Anastien/ACDC120V24/README.md

A generic 120 W, 24 V ac/dc power supply.
