Anastien/ACDC120V24/02_DOCS/DESIGN/Copy of slvc104j.xls

Sheet: Introduction
Designing with the UCC28600 Quasi-Resonant Flyback Converter
 | This worksheet is designed for use with Microsoft Excel 5.0 or later. Its use is intended to assist power supply designers in their |  | © 2013
 | routine, day-to-day calculations.
 |  |  | slvs104J
 | Component values are calculated as ideal, not to nearest production values
 |  | Disclaimer
 |  | This product is designed as an aid for customers of Texas Instruments. No warranties, either express
 |  | or implied, with respect to this software or its fitness for any particular purpose is claimed by Texas
 |  | Instruments or the author. The software is licensed solely on an "as is" basis. The entire risk as to its
 |  | quality and performance is with the customer.

Sheet: Instructions
QR Design Tool Instructions
Be sure to Enable the Macros and to have a check in the AnalysisT oolPak box in the Add-Ins section of the Tools menu.
Quasi-Resonant (QR) flyback converter design is an iterative process. This design tool reduces the hardware iterations by simulating the steady state operating maps that show the converter modes under different input and load conditions. Design adjustments can be explored in order to optimize the power system. Although the design spreadsheet is organized around a bridge rectifier – bulk capacitor line rectifier, it can be used for fixed output Power Factor Corrector (PFC) or voltage follower PFC systems. Systems with PFC must allow the QR flyback stage to start-up under the low ac line condition. However, the steady state conduction losses to the QR flyback stage will only occur at the PFC bulk capacitor voltage levels.
To use this tool, enter the voltages, power levels and converter estimates into the appropriate spaces of the QR Design Tool worksheet. This step also requires an initial selection of the power MOSFET and the output rectifier. Enter data in the cells with the BLUE text; the calculated values are in the cells with the RED text. The parameters for the UCC28600 are already included. The design tool will generate a recommended design that includes transformer parameters. Verify that the current and voltage stresses are compatible with the MOSFET and output rectifier that were initially selected. The recommended values in the design may not be practical due to integer transformer turns, standard values, etc. Yet the operation of the converter can be significantly altered by using the closest parameter.
At this point, design the transformer using the magnetizing inductance and approximate turns ratio that was recommended by the QR Design Tool worksheet. The Magnetic Specification sheet can be printed and used as a guideline for the recommended transformer design. The next step is to see how the design performs using the QR Simulator worksheet.
The QR Simulator will carry over the Converter Requirements, MOSFET Specifications, Diode Data and the UCC28600 Characteristics. The transformer information and the programming components, RS (current sense resistance), RPL (power limit programming), ROVP1 and ROVP2 (over-voltage programming resistors) must be entered by the user. The recommended values are shown beside the cells as a reminder for the ideal values.
After entering the final values, examine the operating maps. They reveal the boundaries of the different modes of operation. The operating maps portray the power levels, peak switch currents, feed back voltages and switching frequencies for the full array of line voltages and loads that the converter would experience. These maps can be used to explore design alternatives, such as different current sense resistor values, different transformers, etc. For example, it might be desirable to change the power level where burst mode occurs in order to avoid audio noise at a common load operating point. The QR Simulator worksheet also shows rms currents, whether the converter is in power limit, the operational mode among other potentially useful data that can be used to optimize the converter performance in a specific power system.
For PFC systems that have a fixed bulk voltage, estimate the PFC output voltage at the peak of its ripple. Calculate the equivalent ac voltage to achieve that maximum voltage level. Enter that ac voltage as the VAC(max) level. Enter the minimum operational ac line voltage as the VAC(min) level because the QR Flyback must power up correctly in order to start the PFC stage.
For voltage follower PFC systems, estimate the PFC output voltage at the peak of its ripple during maximum line conditions. Calculate the equivalent ac voltage to achieve that maximum voltage level. Enter that ac voltage as the VAC(max) level. Enter the minimum ac line voltage as the VAC(min) level because the QR Flyback must power up correctly in order to start the PFC stage. In the least, converter must be designed to operate at safe temperatures under the steady state operating rms currents that occur at the minimum PFC voltage and at the maximum PFC voltage. The data tables in the QR Simulator worksheet can assist in finding the required values.

Sheet: QR Design Tool
UCC28600 Design Spreadsheet
TI Literature Number - SLVC104J - April 2017
Design Synthesis - type in the blue data and the spreadsheet responds with the calculated red data. Bold RED results are recommended COMPONENT VALUES.
 |  |  |  |  |  |  | Comments on REQUIRED USER INPUTS:
 |  |  |  |  |  |  | ALL CELLS WITH BLUE TEXT MUST BE VERIFIED AND UPDATED BY THE USER FOR EACH DESIGN.
Converter Requirements
POUT(max) limit | 150 | W |  |  |  |  | - POUT(max) limit is maximum output power of converter (enter, in W, into cell C10)
RLOAD = | 3.840 | W, VOUT2/POUT |  |  |  |  | - POUT during SS, default: use POUT(max) if design will start into full load (enter, in W, into cell C11)
efficiency ratio | 0.8 |  |  |  |  |  | - efficiency ratio is the Expected converter efficiency (enter, in decimal form, in cell C12)
PIN = | 187.500 | W |  |  |  |  | - Resultant input power from User input (calculated by spreadsheet)
VAC(min) | 85 | VAC | VBULK(min_pk) = | 120.208 | V, VAC(min)Ö2 |  | - VAC(min) is the minimum AC line input voltage (enter, in VAC, in cell C14)
VAC(max) ** | 264 | VAC | VBULK(min_valley) = | 90.156 | V, minus ripple |  | - **For systems with a PFC front end, the VAC(max) value entered into cell C15 should be equivalent to the maximum regulated output voltage of the PFC stage divided by SQRT(2), as calculated by the USER, otherwise, for systems that DO NOT have a PFC input stage, enter the maximum AC line input voltage. (enter, in VAC, in cell C15)
VBULK(ripple), %pp | 25 | % | VBULK(max_pk) = | 373.352 | V, VAC(max)Ö2 |  | - VBULK(ripple), %pp is the ripple voltage on the input voltage (enter the percentage of peak to peak ripple voltage on the input bus in cell C16)
VAC(max) shutdown margin % | 10 | % | VBULK(ov) = | 410.688 | V, plus ripple |  | - VAC(max) shutdown margin % is the User programmable Line Over Voltage Protection limit (enter the percentage of margin that the line voltage can exceed VAC(max) before initiating Line OVP, in cell C17)
Required INPUT CAPACITOR | 470 | uF |  |  |  |  | INPUT CAPACITOR: required minimum input capacitor to meet required VBULK(min_valley) for power stage
Actual Input Capacitor Used | 390 | uF |  |  |  |  | Actual INPUT CAPACITOR used for design. Actual value required for power stage calculations
Actual minimum bulk voltage | 82.847 | V |  |  |  |  | Actual minimum bulk voltage resultant from selection of input capacitor value
fS(min) | 80000 | Hz, low line, max load | tS(min) = | 1.25e-05 | s |  | - Minimum switching frequency at maximum load, minimum input should not be less than 80kHz. Locking this value to 80kHz ensures proper timing for the internal logic of the controller and is not user programable
VOUT | 24 | VDC |  |  |  |  | - VOUT is the regulated output voltage of the converter (enter, in Volts, in cell C19)
VOUT(ripple), max pp | 0.05 | V |  |  |  |  | - VOUT(ripple), max pp is the maximum peak to peak output ripple of the converter output, i.e. usually equal to 1% of the regulated output voltage (enter, in Volts, in cell C20)
VOUT(shutdown) | 17.5 | V |  |  |  |  | - VOUT(shutdown) is the User programmable Output Over Voltage Protection limit (enter, in Volts, the maximum output voltage that will initiate Load OVP in cell C21)
Load step, Watts | 65 | W |  |  |  |  | - Load step is the maximum output load transient, in Watts, i.e. no-load to full load (enter, in Watts, in cell C22)
max dVOUT due to Load step | 0.2 | V |  |  |  |  | - max dVOUT due to Load step is the maximum output voltage deviation due to a transient or load step (enter, in Volts, in cell C23)
estimated fCO, Hz | 3000 | Hz |  |  |  |  | - estimated fCO is the desired crossover frequency of the control loop, usually between 2kHz and 3kHz (enter, in Hertz such as 3.0E+3, in cell C24)
VBIAS at full load | 12 | V |  |  |  |  | - VBIAS is the output of the Aux winding of the Flyback Transformer, used to BIAS the UCC28600 and, if used, also the PFC controller. VBIAS must be equal to the maximum UVLO stop threshold of the UCC28600 (equal to 9.3V) or the maximum start up voltage of the PFC controller, whichever is greater. (enter, in Volts, in cell C25)
Snubber overshoot % of reflected VOUT | 50 | % |  |  |  |  | - Snubber overshoot % of reflected VOUT is used to determine the snubber components. The percentage value entered in this cell will be used to determine the clamp voltage, taking into account the derated VDS of the switch, the maximum input voltage, and the reflected output voltage. Recommended 50% as default value. (enter, as a percentage, in cell C26)
MOSFET Specifications |  |  |  |  |  |  | The User selects a MOSFET for the design and inputs the FET's characteristics:
VDS(max) rating | 800 | V |  |  |  |  | - VDS(max) rating is the chosen FET's drain to Source maximum voltage rating (enter, as Volts, in cell C30)
VDS derate % | 15 | % |  |  |  |  | - VDS derate % is the User chosen derating (for safety margin) of the VDS voltage on the FET (enter, as a percentage, in cell C31)
VDS(max) limit = | 680 | V |  |  |  |  | - Resultant maximum allowed voltage on switch due to User selected derating
COSS estimate, at VDS test V | 3.9e-10 | F | VDS test V | 25 | V |  | - COSS is the output capacitance of the chosen MOSFET as stated in the MOSFET data sheet (enter, in Farads, in cell C33). VDS test V is the defined voltage, found in the MOSFET data sheet, that the COSS specification is tested at (enter, in Volts, in cell F33).
Co', F-sqrt(V) = | 1.95e-09 | F
CDS, stray | 5e-11 | F |  |  |  |  | - CDS, stray is the estimated parasitic Drain to Source capacitance (enter, in Farads, in cell C35) ex.TO-220 tab to GND is about 25 pF
CISS | 1.2e-09 | F |  |  |  |  | - CISS is the input capacitance of the chosen MOSFET as stated in the MOSFET data sheet (enter, in Farads, in cell C36).
Qg | 6e-08 | C |  |  |  |  | - Qg is the total gate charge of the chosen MOSFET as stated in the MOSFET data sheet (enter, in Cou;ombs, in cell C37).
Transformer Estimates
Leakage to magnetizing inductance % | 2.5 | %mag Ind | Leakage to magnetizing inductance ratio = | 0.025 |  |  | - Leakage to magnetizing inductance % is the desired magnetizing inductance of the Flyback transformer (enter, as a percent, in cell C39)
Diode Estimates
VF | 0.700 | V |  |  |  |  | - VF is the forward voltage drop of the User-selected output rectifier as found in the rectifier data sheet (enter, as a voltage, in cell C43)
UCC28600 Parameters |  |  |  |  | Internal IC parameters |  | - The parameters within the blue box are internal to the UCC28600 and are not User programmable.
VFB, no load | 4.87 | V, = VREF in chip, @ no load
RFB | 20000 | W, internal to chip
VFB at Burst/FFM boundary | 1.4 | V
ACS(FB) | 2.5 | Gain, VFB/VCS
VCS(OS), CS offset volts | 0.4 | V, typ value from data sheet
VPL, power limit | 1.2 | V, typical CS value during power limit
VPL - VCS(OS) | 0.8 | V, CS working range
VFB @ power limit | 3 | V, VPL X ACS(FB)
VFB at FFM boundary | 2 | V
fQR(max) clamp | 130000 | Hz
fQR(min) clamp | 40000 | Hz
IOVP(line) | 0.00045 | A, Line OVP typical value in data sheet
VOVP(on), ON state | -0.025 | V, typ VOVP OUT = HIGH
VOVP(load) | 3.75 | V, Load OVP typical value in data sheet
IPL(CS)/IOVPon), current gain during OUT = ON state | 0.5 | 150 mA/300 mA
VCS at DCM/FFM | 0.4 | V, (VFB/ACS(FB)) - VCS(OS)
IP/IP(max) at DCM/FFB boundary | 0.5
VCO gain, TS/VFB | -2.884615385e-05
VCO offset, TS(VFB = 0) | 6.538461538e-05 | V
ISS(chg) | 6e-06 | A, SS charge current
Resulting Converter Features |  |  |  |  |  |  | Note: RS and RPL and the snubber follow simulation because the results are used in their calculation.
VXFMR, reflect | 204.432 | V |  |  |  |  | - calculated allowable reflected output voltage
VDS1(OS) | 102.216 | V |  |  |  |  | - calculated Drain-Source overshoot voltage
ZVS at VAC(min_valley)? | TRUE |  |  |  |  |  | - TRUE only if VXFMR,reflect > VBULK(min_valley), FALSE = valley switching
ZVS at VAC(max_pk)? | FALSE |  |  |  |  |  | - TRUE only if VXFMR,reflect > VBULK(max_pk), FALSE = valley switching
COSS @ VAC(min) | 8.083661252e-11 | F |  |  |  |  | - calaculated circuit capacitances
CDS(total) @ VAC(min) | 1.308366125e-10 | F
COSS @ VAC(max) | 5.265419299e-11 | F
CDS(total) @ VAC(max) | 1.02654193e-10 | F
RLOAD, reflect to pri | 222.892 | W |  |  |  |  | - calculated maximum load impedance based upon the reflected output voltage
tON / sqrt(L) | 0.0008264056844 | s |  |  |  |  | - calculated timing segments normalized with respect to the primary inductance
tLEAKAGE / sqrt(L) | 2.032719204e-06 | s
tOFF / sqrt(L) | 0.0003349055169 | s
tVALLEY / sqrt(L) | 3.183011585e-05 | s
min NPRI / NSEC | 8.277 | turns, N = VXFMR/(VOUT+VF) |  |  |  |  | - min NPRI / NSEC is the Minimum Turns Ratio for the Primary to Secondary Windings (this value is carried over to the Simulator page)
min NPRI / NBIAS | 16.553 | turns, NBIAS = N*(VOUT/VBIAS) |  |  |  |  | - min NPRI / NBIAS is the Minimum Turns Ratio for the Primary to Bias (AUX) Windings (this value is inverted and carried over to the Simulator page)
max Lpri at VAC(min) | 9.844648973e-05 | H |  |  |  |  | - max L at VAC(max) is the Calculated Primary Inductance (this value is carried over to the Simulator page)
LLEAKAGE(max) | 2.461162243e-06 | H |  |  |  |  | - LLEAKAGE(max) is the Allowable Leakage Inductance (this value is carried over to the Simulator page)
Total L input | 0.000100907652 | H | Lpri+Lleakage
1+ROVP1/ROVP2 | 2.427
ROVP1 | 54998.95835 | W |  |  |  |  | - ROVP1 is the ideal value of the top resistor on the OVP pin (this value is adjusted for actual turns ratio and carried over to the Simulator page)
ROVP2 | 38550.67174 | W |  |  |  |  | - ROVP2 is the ideal value of the bottom resistor on the OVP pin (this value is adjusted for actual turns ratio and carried over to the Simulator page)
Ideal Design Using MIN NPRI / NSEC and MAX L over VAC Range @ MAX Load
Trial: the step number for the coresponding input voltage test condition | VBULK: the voltage across the bulk capacitor, iterations begin at the minimum valley voltage | VAC(equiv): the corresponding AC input voltage that would result in VBULK | ZVS ?: if TRUE, converter is zero voltage switching, if FALSE, converter is Valley switching | CDS, total: total drain to source capacitance | IPEAK: calculated peak primary current at maximum load taking into account operating mode | TON: calculated on time at maximum load | TS: calculated switching period at maximum load | IPRI(rms): primary side rms current | TDEMAG: time required for the inductor to demagnetize at maximum load | ISEC(rms): secondary side rms current at maximum load | D: duty cycle
Trial | VBULK | VAC(equiv) | ZVS ? | CDS, total | IPEAK | TON | TS | IPRI(rms) | TDEMAG | ISEC(rms) | D | VOUT/D | resonant leakage | resonant | TR, dMAG(valley) | residue dMAG(l) | Vv, valley VDS
 | V | V |  | F | A | s | s | A, rms | s | A, rms |  | V | time TL1=Tr / (2pi) | f, reset, Hz | seconds | Amps | Volts | TZV | IP1 | TS1 | TL2 | TE1 | IP2 | a | b | c | d
0 | 82.847 | 58.582 | TRUE | 2.800979652e-10 | #NAME? | #NAME? | #NAME? | #NAME? | #NAME? | #NAME? | #NAME? | #NAME? | 2.625579053e-08 | 946679.787 | 3.342299459e-07 | -0.3152434303 | 0 | 3.746010026e-07 | 6.360763413 | 1.088707758e-05 | 1.265040324e-08 | 1.163481472e-05 | 6.967568738 | 2.625239726e-07 | -1.66985288e-06 | -7.35086739e-07 | -8.046622211e-08
1 | 97.372 | 68.853 | TRUE | 2.744925988e-10 | #NAME? | #NAME? | #NAME? | #NAME? | #NAME? | #NAME? | #NAME? | #NAME? | 2.599174523e-08 | 956296.9306 | 3.440485155e-07 | -0.3001512357 | 0 | 3.034622194e-07 | 5.685548217 | 8.698362984e-06 | 1.457080181e-08 | 9.386436265e-06 | 6.288678913 | 2.625239726e-07 | -1.492592704e-06 | -6.735024801e-07 | -8.284299626e-08
2 | 111.898 | 79.124 | TRUE | 2.692778891e-10 | #NAME? | #NAME? | #NAME? | #NAME? | #NAME? | #NAME? | #NAME? | #NAME? | 2.574367056e-08 | 965512.1297 | 3.544061675e-07 | -0.2829573156 | 0 | 2.489431949e-07 | 5.185630361 | 7.235956473e-06 | 1.642625907e-08 | 7.881475765e-06 | 5.789446174 | 2.625239726e-07 | -1.361352283e-06 | -6.29093033e-07 | -8.518050777e-08
3 | 126.423 | 89.394 | TRUE | 2.644104704e-10 | #NAME? | #NAME? | #NAME? | #NAME? | #NAME? | #NAME? | #NAME? | #NAME? | 2.550994054e-08 | 974358.4523 | 3.654832511e-07 | -0.2632872077 | 0 | 2.050237884e-07 | 4.800587877 | 6.201284855e-06 | 1.822306648e-08 | 6.815524902e-06 | 5.407990466 | 2.625239726e-07 | -1.2602694e-06 | -5.960169801e-07 | -8.748143202e-08
4 | 140.948 | 99.665 | TRUE | 2.598534302e-10 | #NAME? | #NAME? | #NAME? | #NAME? | #NAME? | #NAME? | #NAME? | #NAME? | 2.528915679e-08 | 982864.9642 | 3.775460135e-07 | -0.2405710514 | 0 | 1.680289784e-07 | 4.494905685 | 5.436682861e-06 | 1.996663779e-08 | 6.027513648e-06 | 5.107973686 | 2.625239726e-07 | -1.180020497e-06 | -5.708641487e-07 | -8.974815372e-08
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
17 | 329.777 | 233.187 | FALSE | 1.636737962e-10 | #NAME? | #NAME? | #NAME? | #NAME? | #NAME? | #NAME? | #NAME? | #NAME? | 2.007056969e-08 | 1238421.558 | 4.037397417e-07 | 0 | 125.344843 | 0 | 2.97148654 | 2.3759668e-06 | 2.942497134e-08 | 2.829202083e-06 | 3.626780183 | 2.625239726e-07 | -7.800864512e-07 | -4.238103114e-07 | -8.743590629e-08
18 | 344.302 | 243.458 | FALSE | 1.606328595e-10 | #NAME? | #NAME? | #NAME? | #NAME? | #NAME? | #NAME? | #NAME? | #NAME? | 1.988324744e-08 | 1250088.863 | 3.999715659e-07 | 0 | 139.8701067 | 0 | 2.923513625 | 2.299868883e-06 | 3.015024333e-08 | 2.74987394e-06 | 3.58293307 | 2.625239726e-07 | -7.674924109e-07 | -4.198548133e-07 | -8.814464717e-08
19 | 358.827 | 253.729 | FALSE | 1.578579534e-10 | #NAME? | #NAME? | #NAME? | #NAME? | #NAME? | #NAME? | #NAME? | #NAME? | 1.971075937e-08 | 1261028.341 | 3.965017943e-07 | 0 | 154.3953704 | 0 | 2.879424582 | 2.231024034e-06 | 3.087939582e-08 | 2.678115983e-06 | 3.542865832 | 2.625239726e-07 | -7.5591798e-07 | -4.162125537e-07 | -8.891489138e-08
20 | 373.352 | 264.000 | FALSE | 1.55308386e-10 | #NAME? | #NAME? | #NAME? | #NAME? | #NAME? | #NAME? | #NAME? | #NAME? | 1.955093695e-08 | 1271336.829 | 3.932868054e-07 | 0 | 168.9206341 | 0 | 2.838766104 | 2.168463192e-06 | 3.161046627e-08 | 2.612911401e-06 | 3.506114585 | 2.625239726e-07 | -7.45244155e-07 | -4.128377423e-07 | -8.973472019e-08
Summary of Maximum Load at Minimum and Maximum Line
At VAC(min) | IP1 | #NAME? | A |  |  | - IP1 is the peak primary current at low line, full load
 | ICS1 | 4.494848561e-05 | A |  |  | - ICS1 is the power limit current that is sourceed at the CS pin at low line
At VAC(max) | IP2 | #NAME? | A |  |  | - IP2 is the peak primary current at high line, full load
 | ICS2 | 0.0002044953159 | A |  |  | - ICS2 is the power limit current that is sourceed at the CS pin at high line
RS and RPL Values to Achieve IP and ICS
RCS | #NAME? | W | VRcs, peak | #NAME? | V | PRcs | #NAME? | W | - the ideal value of the Current Sense resistor (RCS), the peak voltage across it (VRcs, peak), and the power dissipated by it (PRcs). RCS is adjusted for actual turns ratio and carried over to the QR Simulator page where the User must select a standard value.
RPL | #NAME? | W | VRpl, min line | #NAME? | V | VRpl, max line | #NAME? | V | - the ideal value of the Power Limit Resistor (RPL), the peak voltage across it at minimum line (VRpl, min line), and the peak voltage across it at maximum line (VRpl, max line). RPL is adjusted for actual turns ratio and carried over to the QR Simulator page where the User must select a standard value.
Snubber Components and Parameters, Primary-Side Voltage Clamping
CSNUB | #NAME? | F |  |  |  | - CSNUB is the ideal value of the primary side snubber capacitor. Select a standard value close to this.
TSNUB | #NAME? | s |  |  |  | - TSNUB is the period of the ringing frequency
RSNUB1 | #NAME? | W | PRsnub1 | #NAME? | W | - RSNUB1 is the ideal value of the snubber resistor that is in parallel to CSNUB, PRsnub1 is the power dissipation of RSNUB1. Select a standard value close to this.
RSNUB2 | #NAME? | W |  |  |  | - RSNUB2 is the ideal value of the snubber resistor that is in series with CSNUB. Select a standard value close to this.
Output Capacitor
COUT | 0.0003385416667 | F |  |  |  | - COUT is the ideal value of the output capacitor. Select a standard value close to this.
ESR, max | #NAME? | W |  |  |  | - Select a capacitor bank (COUT) with a total ESR less than this.
IC(out), rms @ low line | #NAME? | A |  |  |  | - Select a capacitor bank (COUT) to handle IC(out),rms at low line.
IC(out), rms @ high line | #NAME? | A |  |  |  | - Select a capacitor bank (COUT) to handle IC(out),rms at high line.
Input Bulk Capacitor | 390 | uF
Soft Start
tSS, minimum | 0.002664037957 | s |  |  |  | - tSS, minimum is the required soft start time
CSS, minimum | 7.992113871e-09 | F |  |  |  | - CSS, minimum is the rewquired capacitor fo SS. Select astandard value close to this.
Summary of Ideal Converter Components
Xfmr | LPRI(terminal) | 9.844648973e-05 | H |  |  | - LPRI(terminal) is the required primary inductance. LPRI is carried over to the QR Simulator page where the User must select a standard value.
 | LPRI(leakage) | 2.461162243e-06 | H |  |  | - LPRI(leakage) is the maximum allowable leakage inductance. LPRI(leakage) is carried over to the QR Simulator page where the User must select a standard value.
 | NPRI/NSEC | 8.277 | turns ratio |  |  | - NPRI/NSEC is the ideal primary to secondary turns ratio. NPRI/NSEC is carried over to the QR Simulator page where the User must enter the actual turns used.
 | IPRI(rms) | #NAME? | ARMS |  |  | - IPRI(rms) is the primary rms current at low line, maximum load
 | IPRI(peak) | #NAME? | APEAK |  |  | - IPRI(peak) is the peak primary current at low line, maximum load
 | ISEC(rms) @ low line | #NAME? | ARMS, for non-PFC design |  |  | - ISEC(rms) @ low line is the maximum secondary side rms current at low line for designs without a PFC front end
 | ISEC(rms) @ high line | #NAME? | ARMS, for PFC design |  |  | - ISEC(rms) @ high line is the maximum secondary side rms current at high line for designs with a PFC front end
MOSFET | VDS rating | 800 | V |  |  | - VDS rating is the voltage rating on the User selected MOSFET
 | VDS stress | 680 | V |  |  | - VDS stress is the resultant maximum allowed voltage on switch due to User selected derating
 | ID(rms) | #NAME? | A |  |  | - ID(rms) is the maximum primary rms current
Output capacitor | COUT | 0.0003385416667 | F |  |  | - COUT is the ideal value of the output capacitor. Select a standard value close to this.
 | ESR, max | #NAME? | W |  |  | - ESR, max is the maximum allowable equivalent series resitance of the output capacitor bank
 | rms current rating @ low line | #NAME? | ARMS |  |  | - rms current rating at low line is the required rms ripple current rating for low line operation of designs that do not use a PFC front end
 | rms current rating @ high line | #NAME? | ARMS |  |  | - rms current rating at high line is the required rms ripple current rating for low line operation of designs that use a PFC front end
Output Diode | VF | 0.7 | V |  |  | - VF is the forward voltage drop of the selected diode
 | IAVERAGE | 6.250 | A |  |  | - IAVERAGE is the average output current
 | IRMS | #NAME? | A |  |  | - IRMS is the RMS output current
 | IPEAK | #NAME? | A |  |  | - IPEAK is the PEAK output current
 | PDISSIPATE | 4.375 | W |  |  | - PDISSIPATE is the calculated power dissipation of the output diode
 | VBLOCK | 69.109 | V |  |  | - VBLOCK is the required reverse voltage rating of the diode
R current sense | RCS | #NAME? | W |  |  | - RCS is the ideal value of the Current Sense resistor
 | maximum power | #NAME? | W |  |  | - maximum power is the calculated dissipated power across the current sense resistor
R power limit | RPL | #NAME? | W |  |  | - RPL is the ideal value of the power limit resistor
R2CD snubber | CSNUB | #NAME? | F |  |  | - CSNUB is the ideal value of the primary side snubber capacitor. Select a standard value close to this.
 | RSNUB1 | #NAME? | W |  |  | - RSNUB1 is the ideal value of the snubber resistor that is in parallel to CSNUB, Select a standard value close to this.
 | PRsnub1 | #NAME? | W |  |  | - PRsnub1 is the power dissipation of RSNUB1.
 | RSNUB2 | #NAME? | W |  |  | - RSNUB2 is the ideal value of the snubber resistor that is in series with CSNUB. Select a standard value close to this.
OVP | ROVP1 | 54998.95835 | W |  |  | - ROVP1 is the ideal value of the top resistor on the OVP pin
 | ROVP2 | 38550.67174 | W |  |  | - ROVP2 is the ideal value of the bottom resistor on the OVP pin
Soft start | CSS | 7.992113871e-09 | F |  |  | - CSS, minimum is the required capacitor fo SS. Select astandard value close to this.
 | tSS | 0.002664037957 | s |  |  | - tSS, minimum is the required soft start time
Minimum VDD Capacitor | CVDD | 5.429309356e-06 | F |  |  | - CVDD is the minimum required value for the bulk capacitor on VDD
Series resistor | RVDD | #NAME? | W |  |  | - RVDD is the series resistor from the Bias windings into VDD
Start up resistor | RSU | 3313884.257 | W |  |  | - RSU is the start up resistor from the bulk input into VDD

Sheet: QR Simulator
UCC28600 Analysis Spreadsheet
TI Literature Number - SLVC104J - April 2017
 | Design Simulation - type in the blue data and it responds with the red data.
Note: The converter requirements and recommended component values have been carried over from the QR Designer Tool page and are shown in RED. The USER MUST TYPE IN STANDARD COMPONENT VALUES IN THE BLUE CELLS FOR THE SIMULATOR TO GENERATE THE DESIGN SPECIFIC MODE CHARTS
 |  |  |  |  |  | OPERATING MODE MAPS
Converter Requirements:
POUT | 150 | W |  |  |  |  |  |  |  |  |  |  |  |  |  |  |  |  |  |  |  |  |  |  |  |  | PLOAD/PRATED | IP actual | fS actual
RLOAD during SS | 3.840 | W |  |  |  |  |  |  |  |  |  |  |  |  |  |  |  |  |  |  |  |  |  |  |  |  |  | A | Hz
Efficiency ratio | 0.8 |  |  |  |  |  |  |  |  |  |  |  |  |  |  |  |  |  |  |  |  |  |  |  |  |  | 1 | 3.076 | 72767.01418
PIN | 187.500 | W |  |  |  |  |  |  |  |  |  |  |  |  |  |  |  |  |  |  |  |  |  |  |  |  | 0.95 | 2.926 | 76420.09818
VAC(min) | 85 | VAC | VBULK(min_pk) | 120.208 | V |  |  |  |  |  |  |  |  |  |  |  |  |  |  |  |  |  |  |  |  |  | 0.9 | 2.775 | 80459.45146
VAC(max) | 264 | VAC | VBULK(min_valley) | 82.847 | V |  |  |  |  |  |  |  |  |  |  |  |  |  |  |  |  |  |  |  |  |  | 0.85 | 2.625 | 84949.69563
VBULK(ripple), %pp | 25 | % | VBULK(max_pk) | 373.352 | V |  |  |  |  |  |  |  |  |  |  |  |  |  |  |  |  |  |  |  |  |  | 0.8 | 2.475 | 89970.87814
VAC(max) shutdown margin % | 10 | % | VBULK(shutdown) | 410.688 | V |  |  |  |  |  |  |  |  |  |  |  |  |  |  |  |  |  |  |  |  |  | 0.75 | 2.324 | 95623.06913
fS(min) | 80000 | Hz | TS(min) | 1.25e-05 | s |  |  |  |  |  |  |  |  |  |  |  |  |  |  |  |  |  |  |  |  |  | 0.7 | 2.174 | 102033.2321
VOUT | 24 | V |  |  |  |  |  |  |  |  |  |  |  |  |  |  |  |  |  |  |  |  |  |  |  |  | 0.65 | 2.023 | 109364.8192
VOUT(ripple), max pp | 0.05 | V |  |  |  |  |  |  |  |  |  |  |  |  |  |  |  |  |  |  |  |  |  |  |  |  | 0.6 | 1.873 | 117832.0074
VOUT, shut-down | 17.5 | V |  |  |  |  |  |  |  |  |  |  |  |  |  |  |  |  |  |  |  |  |  |  |  |  | 0.55 | 1.722 | 127720.921
Load step, Watts | 65 | W |  |  |  |  |  |  |  |  |  |  |  |  |  |  |  |  |  |  |  |  |  |  |  |  | 0.5 | 1.627 | 130000
max dVOUT due to load step | 0.2 | V |  |  |  |  |  |  |  |  |  |  |  |  |  |  |  |  |  |  |  |  |  |  |  |  | 0.45 | 1.544 | 130000
estimated fCO, Hz | 3000 | Hz |  |  |  |  |  |  |  |  |  |  |  |  |  |  |  |  |  |  |  |  |  |  |  |  | 0.4 | 1.503 | 121994.4605
VBIAS at full load | 12 | V |  |  |  |  |  |  |  |  |  |  |  |  |  |  |  |  |  |  |  |  |  |  |  |  | 0.35 | 1.503 | 106745.153
Snubber overshoot % of reflected VOUT | 50 | % |  |  |  |  |  |  |  |  |  |  |  |  |  |  |  |  |  |  |  |  |  |  |  |  | 0.3 | 1.503 | 91495.84539
COUT | 0.0003385416667 | F |  |  |  |  |  |  |  |  |  |  |  |  |  |  |  |  |  |  |  |  |  |  |  |  | 0.25 | 1.503 | 76246.53783
CBULK | 390 | uF |  |  |  |  |  |  |  |  |  |  |  |  |  |  |  |  |  |  |  |  |  |  |  |  | 0.2 | 1.503 | 60997.23026
MOSFET Specifications: |  |  |  |  |  |  |  |  |  |  |  |  |  |  |  |  |  |  |  |  |  |  |  |  |  |  | 0.15 | 1.503 | 45747.9227
VDS(max) rating | 800 | V |  |  |  |  |  |  |  |  |  |  |  |  |  |  |  |  |  |  |  |  |  |  |  |  | 0.1 | 1.503 | 30498.61513
VDS derate % | 15 | % | Actual derating % | 29.866 | % |  |  |  |  |  |  |  |  |  |  |  |  |  |  |  |  |  |  |  |  |  | 0.05 | 1.503 | 15249.30757
VDS(max) limit | 680 | V |  |  |  |  |  |  |  |  |  |  |  |  |  |  |  |  |  |  |  |  |  |  |  |  | 0.01 | 1.503 | 3049.861513
COSS estimate, at VDS = 25 V | 3.9e-10 | F | VDS test V | 25 | V
Co', F-sqrt(V) | 1.95e-09 | F
CDS, stray | 5e-11 | F
Diode Data:
VF | 0.700 | V
Transformer Data
Actual Leakage to magnetizing inductance % (from magnetic manufacturer's drawing spec) | 2 | % | Leakage to magnetizing inductance ratio | 0.02
Actual LM (from magnetic manufacturer's drawing spec). The recommended primary inductance is shown in cell E42, carried over from the QR Design page. | 0.000218 | H | Recommended LM carried over from QR Design page and shown for the User's convenience in cell E42 | 9.844648973e-05 | H
LLEAKAGE | 4.36e-06 | H
Total L, primary | 0.00022236 | H
Input the actual Primary to Secondary Turns Ratio, from the magnetic manufacturer's drawing spec, into cell B47. This value should very closely match the recommended turns ratio calculated on the QR Design Tool sheet and shown for the User's convenience in cell E47 of this sheet.
NPRI/NSEC (from magnetic manufacturer's drawing spec) | 7.600 | turns ratio |  | 8.277 | Recommended NPRI/NSEC turns ratio
VXFMR, reflect | 187.720 | V | Recommended VXFMR, reflect | 204.4 | V
Input the actual Primary to Bias Turns Ratio, from the magnetic manufacturer's drawing spec, into cell B50. This value should very closely match the recommended turns ratio calculated on the QR Design Tool sheet and shown, for the User's convenience, in cell E50 of this sheet.
NPRI/NBIAS | 9.500 |  |  | 16.553 | Recommended NPRI/NBIAS turns ratio
ACTUAL Output Voltage | 24 | V
ACTUAL Bias Voltage | 19.2 | V
Sense Resistors & Power Limit |  |  | Recommended values, carried over from the QR Design Tool page and adjusted for the actual turns ratio are shown in cells D54 through D57. The User must insert the closest standard value for each component in cells B54 through B57, iterating until the recommended values no longer self-adjust (usually 2-3 iterations are all that are needed) |  |  | In regards to the above Mode Plots: The green shaded region represents the Green Mode area of operation where the controller applies packets of 40kHz pulses to the MOSFET gate. The frequency shown is actually the average switching frequency of the 40kHz packets of pulses while in this region. Ideally, a design will transition from Green mode into Frequency Foldback mode (FFM) at approximately 10% load. From FFM, with increasing load, the converter will either operate in Discontinuous Mode (DCM) at which point the frequency will be fixed at 130kHz, or transition directly into Quasi-Resonant mode (QR) where the frequency will decrease with increasing load. Due to the limitaions of this QR Simulator spreadsheet. the Mode plots do NOT accurately show the internal 40kHz clamp of Quasi-Resonant operation. As shown below, once the switching frequency hits the internal 40kHz minimum frequency clamp, the operating frequency will begin to increase with increasing load, dependent upon line and load conditions. |  |  |  |  |  |  | fs, actual (kHz) for Rated P map 1, 2, 3 | fs, actual (kHz) for Input Low Line Map 1, 2, 3 | fs, actual (kHz) for Input High Line Map 1, 2, 3 | fs, actual (kHz) for Power Limit Map 1, 2
RCS, current sense | 0.270 | W | #NAME? | W |  |  |  |  |  |  |  |  | #NAME? | #NAME? | #NAME? | 89.51412695
RPL, power limit | 1780 | W | #NAME? | W |  |  |  |  |  |  |  |  | #NAME? | #NAME? | #NAME? | 102.0730333
ROVP1 | 96000 | W | 95851.57548 | W |  |  |  |  |  |  |  |  | #NAME? | #NAME? | #NAME? | 114.2465373
ROVP2 | 33000 | W | 33251.00907 | W |  |  |  |  |  |  |  |  | #NAME? | #NAME? | #NAME? | 126.1929562
 |  |  |  |  |  |  |  |  |  |  |  |  | #NAME? | #NAME? | #NAME? | 138.0768637
 |  |  |  |  |  |  |  |  |  |  |  |  | #NAME? | #NAME? | #NAME? | 150.1015545
UCC28600 Parameters |  |  |  |  |  |  |  |  |  |  |  |  | #NAME? | #NAME? | #NAME? | 162.6073746
VFB, no load | 4.87 | V, = VREF in chip, @ no load |  |  |  |  |  |  |  |  |  |  | #NAME? | #NAME? | #NAME? | 176.8000748
RFB | 20000 | W, internal to chip |  |  |  |  |  |  |  |  |  |  | #NAME? | #NAME? | #NAME? | 168.5209728
VFB at Burst/FFM boundary | 1.4 | V |  |  |  |  |  |  |  |  |  |  | #NAME? | #NAME? | #NAME? | 177.8534277
ACS(FB) | 2.5 | Gain, VFB/VCS |  |  |  |  |  |  |  |  |  |  | #NAME? | #NAME? | #NAME? | 186.9896031
VCS(OS), CS offset volts | 0.4 | V, typ value from data sheet |  |  |  |  |  |  |  |  |  |  | #NAME? | #NAME? | #NAME? | 196.0581884
VPL, power limit | 1.2 | V, typical CS value during power limit |  |  |  |  |  |  |  |  |  |  | #NAME? | #NAME? | #NAME? | 205.1248144
VPL - VCS(OS) | 0.8 | V, CS working range |  |  |  |  |  |  |  |  |  |  | #NAME? | #NAME? | #NAME? | 214.2377053
VFB @ power limit | 3 | V, VPL X ACS(FB) |  |  |  |  |  |  |  |  |  |  | #NAME? | #NAME? | #NAME? | 223.4377969
VFB at FFM boundary | 2 | V |  |  |  |  |  |  |  |  |  |  | #NAME? | #NAME? | #NAME? | 232.762378
fQR(max) clamp | 130000 | Hz |  |  |  |  |  |  |  |  |  |  | #NAME? | #NAME? | #NAME? | 242.2468317
fQR(min) clamp | 40000 | Hz |  |  |  |  |  |  |  |  |  |  | #NAME? | #NAME? | #NAME? | 251.925656
IOVP(line) | 0.00045 | A, Line OVP typical value in data sheet |  |  |  |  |  |  |  |  |  |  | #NAME? | #NAME? | #NAME? | 261.8331609
VOVP(on), ON state | -0.025 | V, typ VOVP OUT = HIGH |  |  |  |  |  |  |  |  |  |  | #NAME? | #NAME? | #NAME? | 272.0040027
VOVP(load) | 3.75 | V, Load OVP typical value in data sheet |  |  |  |  |  |  |  |  |  |  | #NAME? | #NAME? | #NAME? | 282.4736286
IPL(CS)/IOVPon), current gain during OUT = ON state | 0.5 | 150 mA/300 mA
VCS at DCM/FFM | 0.4 | V, (VFB/ACS(FB)) - VCS(OS)
IP/IP(max) at DCM/FFB boundary | 0.5
VCO gain, TS/VFB | -2.884615385e-05 |  |  |  |  |  |  |  |  |  |  |  |  |  | Ipeak actual | #NAME?
VCO offset, TS(VFB = 0) | 6.538461538e-05 | V |  |  |  |  |  |  |  |  |  |  |  |  | fs | #NAME?
ISS(chg) | 6e-06 | A, SS charge current
 | Operation Characteristics of Design Using LM and LLEAK at Full Rated Power
 | Trial | VBULK | VAC, equiv. | IP, actual | TS, actual | TON, actual | fS, actual | Power Limit? | VFB | IPRI(rms) | ISEC(rms) |  |  | resonant leakage | resonant | TR, dMAG(valley) | residue dMAG(l) | VV, valley VDS
 |  | V | V | A | s | s | Hz |  | V | ARMS | ARMS | ZVS ? | CDS, total | time TL1=Tr / (2pi) | f, reset, Hz | seconds | Amps | Volts | TZV | IP1 | TS1 | TL2 | TE1 | IP2 | a | b | c | d | TD(mag) | D1, actual | ICS(pl) | VCS(pk) | PIN
Recommended with Turns ADJ | 0 | 82.847 | 58.582 | #NAME? | #NAME? | #NAME? | #NAME? | #NAME? | #NAME? | #NAME? | #NAME? | TRUE | 2.87097573e-10 | 3.538001439e-08 | 629907.8757 | 5.12372051e-07 | -0.1933105862 | 0 | 5.086684328e-07 | 6.524066434 | 2.523841906e-05 | 1.190655558e-08 | 2.630674611e-05 | 6.936230755 | 5.9296e-07 | -3.868510432e-06 | -1.056420498e-06 | -7.767915959e-08 | #NAME? | #NAME? | 4.49845573e-05 | #NAME? | 187.5
 | 20 | 373.352 | 264.000 | #NAME? | #NAME? | #NAME? | #NAME? | #NAME? | #NAME? | #NAME? | #NAME? | FALSE | 1.545249552e-10 | 2.595628642e-08 | 858603.1664 | 5.823412021e-07 | 0 | 185.6323805 | 0 | 3.002069125 | 5.344003989e-06 | 2.887997606e-08 | 5.981181453e-06 | 3.427212744 | 5.9296e-07 | -1.780106908e-06 | -6.082974885e-07 | -8.669968447e-08 | #NAME? | #NAME? | 0.0002044994238 | #NAME? | 187.5
Actual with Real Values | 0 | 82.847 | 58.582 | #NAME? | #NAME? | #NAME? | #NAME? | #NAME? | #NAME? | #NAME? | #NAME? | TRUE | 2.87097573e-10 | 3.538001439e-08 | 629907.8757 | 5.12372051e-07 | -0.1933105862 | 0 | 5.086684328e-07 | 6.524066434 | 2.523841906e-05 | 1.266959994e-07 | 2.642153556e-05 | 6.966496986 | 5.9296e-07 | -3.868510432e-06 | -1.056420498e-06 | -7.767915959e-08 | #NAME? | #NAME? | 4.491156652e-05 | #NAME? | 187.5
 | 1 | 97.372 | 68.853 | #NAME? | #NAME? | #NAME? | #NAME? | #NAME? | #NAME? | #NAME? | #NAME? | TRUE | 2.809786346e-10 | 3.500095494e-08 | 636729.7619 | 5.289432461e-07 | -0.1822047025 | 0 | 4.079250108e-07 | 5.848851238 | 2.028460469e-05 | 1.369582874e-08 | 2.127016973e-05 | 6.255689064 | 5.9296e-07 | -3.46813483e-06 | -9.718692119e-07 | -8.01048649e-08 | #NAME? | #NAME? | 5.287497864e-05 | #NAME? | 187.5
 | 2 | 111.898 | 79.124 | #NAME? | #NAME? | #NAME? | #NAME? | #NAME? | #NAME? | #NAME? | #NAME? | TRUE | 2.753102358e-10 | 3.464610552e-08 | 643251.2218 | 5.466597121e-07 | -0.1693812307 | 0 | 3.299900724e-07 | 5.348933382 | 1.696523093e-05 | 1.542135516e-08 | 1.789194818e-05 | 5.753938513 | 5.9296e-07 | -3.171703538e-06 | -9.1129589e-07 | -8.248780142e-08 | #NAME? | #NAME? | 6.083839076e-05 | #NAME? | 187.5
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
 | 0.3 | 45 | 56.250 | #NAME? | #NAME? | #NAME? | #NAME? | #NAME? | #NAME? | 1.95721993 | 7.571525718e-06 | 3.96885186e-08 | 8.667634735e-06 | 2.285372518 | 1.976533333e-06 | -3.868510432e-06 | -1.056420498e-06 | -7.767915959e-08 | #NAME? | #NAME? | #NAME? | #NAME? | #NAME? | 360053.9735 | #NAME? | #NAME? | #NAME?
 | 0.25 | 37.5 | 46.875 | #NAME? | #NAME? | #NAME? | #NAME? | #NAME? | #NAME? | 1.631016608 | 6.309604765e-06 | 4.762622232e-08 | 7.413651486e-06 | 1.954738044 | 2.37184e-06 | -3.868510432e-06 | -1.056420498e-06 | -7.767915959e-08 | #NAME? | #NAME? | #NAME? | #NAME? | #NAME? | 300044.9779 | #NAME? | #NAME? | #NAME?
 | 0.2 | 30 | 37.500 | #NAME? | #NAME? | #NAME? | #NAME? | #NAME? | #NAME? | 1.304813287 | 5.047683812e-06 | 5.95327779e-08 | 6.163637088e-06 | 1.625150026 | 2.9648e-06 | -3.868510432e-06 | -1.056420498e-06 | -7.767915959e-08 | #NAME? | #NAME? | #NAME? | #NAME? | #NAME? | 240035.9824 | #NAME? | #NAME? | #NAME?
 | 0.15 | 22.5 | 28.125 | #NAME? | #NAME? | #NAME? | #NAME? | #NAME? | #NAME? | 0.978609965 | 3.785762859e-06 | 7.937703719e-08 | 4.921560394e-06 | 1.297654922 | 3.953066667e-06 | -3.868510432e-06 | -1.056420498e-06 | -7.767915959e-08 | #NAME? | #NAME? | #NAME? | #NAME? | #NAME? | 180026.9868 | #NAME? | #NAME? | #NAME?
 | 0.1 | 15 | 18.750 | #NAME? | #NAME? | #NAME? | #NAME? | #NAME? | #NAME? | 0.6524066434 | 2.523841906e-06 | 1.190655558e-07 | 3.69932796e-06 | 0.9753921012 | 5.9296e-06 | -3.868510432e-06 | -1.056420498e-06 | -7.767915959e-08 | #NAME? | #NAME? | #NAME? | #NAME? | #NAME? | 120017.9912 | #NAME? | #NAME? | #NAME?
 | 0.05 | 7.5 | 9.375 | #NAME? | #NAME? | #NAME? | #NAME? | #NAME? | #NAME? | 0.3262033217 | 1.261920953e-06 | 2.381311116e-07 | 2.556472563e-06 | 0.6740584159 | 1.18592e-05 | -3.868510432e-06 | -1.056420498e-06 | -7.767915959e-08 | #NAME? | #NAME? | #NAME? | #NAME? | #NAME? | 60008.99559 | #NAME? | #NAME? | #NAME?
 | 0.01 | 1.5 | 1.875 | #NAME? | #NAME? | #NAME? | #NAME? | #NAME? | #NAME? | 0.06524066434 | 2.523841906e-07 | 1.190655558e-06 | 2.499460247e-06 | 0.6590261281 | 5.9296e-05 | -3.868510432e-06 | -1.056420498e-06 | -7.767915959e-08 | #NAME? | #NAME? | #NAME? | #NAME? | #NAME? | 12001.79912 | #NAME? | #NAME? | #NAME?
 | Operation Characteristics of Design Using LM and LLEAK at High Line
 | VBULK(min) | 373.3523805 | V | VAC, equiv | 264 | V
 | PLOAD/PRATED | Pload | PLINE | Mode | IP actual | fS actual | TON | VCS | VFB
 |  | W | W |  | A | Hz | s | V | V | Ip1 | TS1 | TL2 | TE1 | Ip2 | a | b | c | d | Ip, actual qr | Ts, actual qr | Ton, actual qr | fs, actual qr | Vcs,mx if QR | fs, FFB | Ip/Ipmx | Ts actual | Tdmag
 | 1 | 150 | 187.500 | #NAME? | #NAME? | #NAME? | #NAME? | #NAME? | #NAME? | 3.002069125 | 5.344003989e-06 | 2.887997606e-08 | 5.981181453e-06 | 3.427212744 | 5.9296e-07 | -1.780106908e-06 | -6.082974885e-07 | -8.669968447e-08 | #NAME? | #NAME? | #NAME? | #NAME? | #NAME? | 91979528.06 | #NAME? | #NAME? | #NAME?
 | 0.95 | 142.5 | 178.125 | #NAME? | #NAME? | #NAME? | #NAME? | #NAME? | #NAME? | 2.851965669 | 5.076803789e-06 | 3.03999748e-08 | 5.715501253e-06 | 3.274978177 | 6.241684211e-07 | -1.780106908e-06 | -6.082974885e-07 | -8.669968447e-08 | #NAME? | #NAME? | #NAME? | #NAME? | #NAME? | 87380551.66 | #NAME? | #NAME? | #NAME?
 | 0.9 | 135 | 168.750 | #NAME? | #NAME? | #NAME? | #NAME? | #NAME? | #NAME? | 2.701862212 | 4.80960359e-06 | 3.208886229e-08 | 5.449989941e-06 | 3.122840383 | 6.588444444e-07 | -1.780106908e-06 | -6.082974885e-07 | -8.669968447e-08 | #NAME? | #NAME? | #NAME? | #NAME? | #NAME? | 82781575.26 | #NAME? | #NAME? | #NAME?
 | 0.85 | 127.5 | 159.375 | #NAME? | #NAME? | #NAME? | #NAME? | #NAME? | #NAME? | 2.551758756 | 4.54240339e-06 | 3.397644243e-08 | 5.184677321e-06 | 2.97081644 | 6.976e-07 | -1.780106908e-06 | -6.082974885e-07 | -8.669968447e-08 | #NAME? | #NAME? | #NAME? | #NAME? | #NAME? | 78182598.85 | #NAME? | #NAME? | #NAME?
 | 0.8 | 120 | 150.000 | #NAME? | #NAME? | #NAME? | #NAME? | #NAME? | #NAME? | 2.4016553 | 4.275203191e-06 | 3.609997008e-08 | 4.91960065e-06 | 2.818927694 | 7.412e-07 | -1.780106908e-06 | -6.082974885e-07 | -8.669968447e-08 | #NAME? | #NAME? | #NAME? | #NAME? | #NAME? | 73583622.45 | #NAME? | #NAME? | #NAME?
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
 | 20 | 373.352 | 282473.6286 | 82.104 | 0.487 | 5.218 | FALSE | 1.545249552e-10 | 0.0002041798089 | 0.3634400598 | 1.616888667 | 9.629813091e-07 | 7.957759395e-08 | 1.915253378e-06 | 0 | 0 | 5.823412021e-07 | 3.540153483e-06

Sheet: Magnetic Specification
Flyback Inductor Specification for the UCC28600 Greenmode Quasi-Resonant Converter
The flyback transformer plays a crucial role in the performance of the green mode controller. Considerations must be given to adequate coupling for the bias windings, minimizing leakage inductance, and minimizing audible noise. All of these criteria can easily be met with proper transformer design from the start.
GENERAL:
Topology: | Quasi-Resonant Flyback with Bias Winding
Main Output Power: | 150 | W
Anticipated Overall Efficiency of the Converter: | 0.8
Maximum Switching Frequency, min input, max load: | 80000 | Hz at full load, min input
Maximum Switching Frequency: | 130000 | Hz, DCM mode
Minimum Switching Frequency: | Burst packets of 40kHz pulses at loads of 15% or less
INPUT:
Minimum Input Voltage: | 82.85 | V
Maximum Input Voltage: | 373.35 | V
Peak PRIMARY Current: | #NAME? | A
PRIMARY RMS Current: | #NAME? | A
Duty Cycle at Minimum Input Voltage, Maximum Load: | #NAME?
Duty Cycle at Maximum Input Voltage, Maximum Load: | #NAME?
OUTPUTS:
SECONDARY Output Voltage: | 24 | V
SECONDARY Output Peak Current: | #NAME? | A
SECONDARY RMS Current: | #NAME? | A
BIAS Voltage: | 19.2 | V
Approximate RMS BIAS Current: | 0.03554883721 | A
INDUCTANCE AND TURNS RATIO:
Magnetizing Inductance: | 0.000218 | H
Maximum Leakage Inductance: | 4.36e-06 | H
PRIMARY to SECONDARY Turns Ratio (NPRI/NSEC): | 7.600
PRIMARY to BIAS Turns Ratio (NPRI/NBIAS): | 9.500
Isolation Requirement: |  |  | fill in specific requirement for application
SPECIAL NOTES REGARDING THE FLYBACK TRANSFORMER:
1. The BIAS windings must be well coupled to the PRIMARY. Interleave BIAS and SECONDARY windings between the primary for equal coupling.
2. Use bundled stranded wire.
3. Encase the windings in as much Ferrite as possible; a round post core is a must to help reduce leakage.
4. Do not use tape barriers. Use triple insulated wire on the SECONDARY to meet the isolation requirement while minimizing leakage inductance.
5. Must be potted or heavily varnished to reduce audible noise. Also, fill the gap with flexible epoxy to reduce audible noise.
6. Distribute the BIAS windings over the entire width of the bobbin.
7. Place the dot end of the PRIMARY winding as close to the core as possible to help shield the dv/dt noise.
8. Wind the SECONDARY so that the non-dot end is the outer most layer.
Example of a recommended transformer design. Use multiple strand wire to distribute each of the coils across the layer.
For more information refer to: http://focus.ti.com/lit/an/slua418/slua418.pdf
