Anastien/ACDC120V24/02_DOCS/TEST/Prototype test.docx

DC Bridge Tests

1. ON-OFF functionality

Test on off switch

2. Fuse test
3. DC level test
4. Diode bridge temperature test

Flyback Controller Test

1. Isolated feed-back test
2. Power on test with external DC bus PS and external controller PS
3. Output voltage level test with loading
