Anastien/ACDC120V24/02_DOCS/DESIGN/printable_z_paper_20181001.pdf

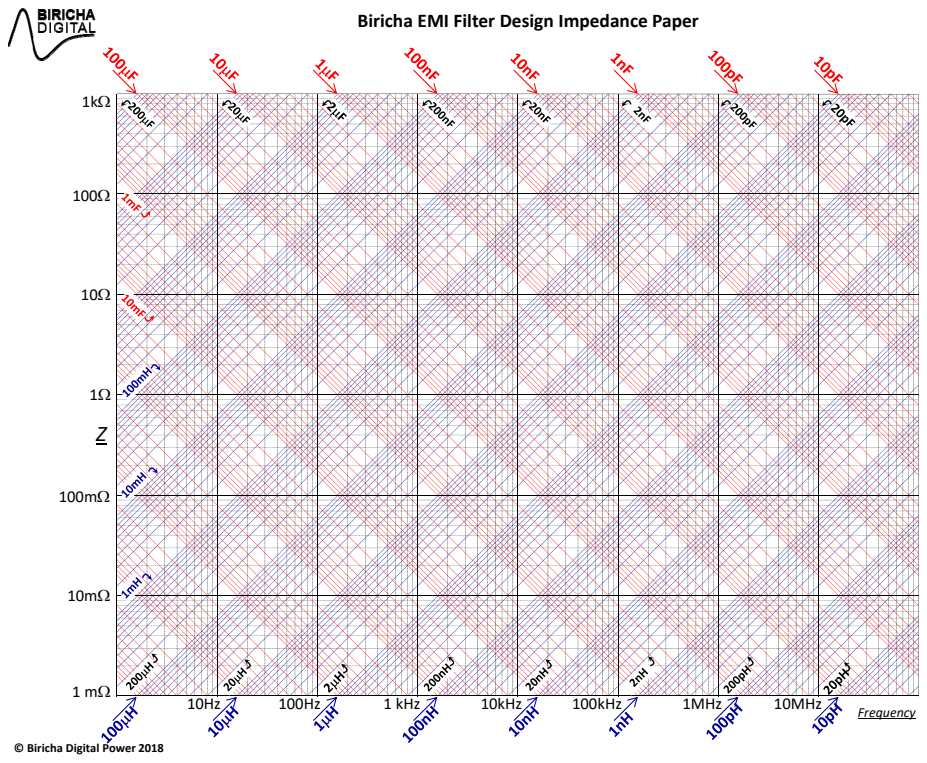
[picture p1: page 1]
10MHz 1 kHz; 10kHz; 100kHz; 1MHz; Frequency

Biricha EMI Filter Design Impedance Paper

© Biricha Digital Power 2018
