Anastien/ACDC120V24/02_DOCS/SIMULATION/Draft2.asc

C1: cap; 270µ
C2: cap; 2200µ
D1: schottky; B540C
L1: ind2; 300µ
L2: ind2; 300µ
L3: ind; 10µ
M1: nmos; STW11NM80
R1: res; 50
V1: voltage; {Vin/9.9}
V2: voltage; PULSE(0 10 0 1n 1n {D/Fsw} {1/Fsw})
Named nets: 0, VO
.param Vin=300 D={9.9*23.6/(23.6*9.9+Vin)} Fsw=40k
K L1 L2 1
.tran 0 0.8 0.6
