Anastien/ACDC120V24/02_DOCS/SIMULATION/Feedback_circuit.asc

C1: cap; 43p
C2: cap; 27n
C3: cap; 200p
R1: res; 35.2k
R2: res; 4.12k
R3: res; 1.5k
R4: res; 1k
R5: res; 1k
R6: res; 93..1k
R7: res; 20k
U1: TL431
U2: DI_MMSZ5240B
U3: CNY17-1
V1: voltage; PULSE(0 25 0.5 10 0.5 25 0.5 30)
V2: voltage; 5
Named nets: 0
.tran 100
