Anastien/ACDC120V24/02_DOCS/SIMULATION/EMI_IN_FILT_DM_DAMPING.asc

C1: cap; 1µ; V=310 Irms=0 Rser=0.002 Lser=13.1n
C2: cap; 1µ; V=310 Irms=0 Rser=0.002 Lser=13.1n
C3: cap; 5µ
L1: WE-FCLP
R1: res; 10.7
V1: voltage; SINE(0 230 50); AC 1; Rser=0.001
Named nets: 0, VIN, VOUT
.ac dec 20000 10 50Meg
;tran 1
