Anastien/ACDC120V24/02_DOCS/SIMULATION/Snubber/R2CD.asc

C1: cap; 4.7n
D1: diode; VS-E5TH1506
L1: ind; 6µ; Rser=0
R1: res; 10
R2: res; 550
Named nets: 0, 1
.tran 1m
.ic I(L1)=4.55
.IC V(1) =0
R2CD Snubber
