Anastien/ACDC120V24/01_ECAD/ACDC120V24.kicad_pcb

## KiCad design 01_ECAD/ACDC120V24.kicad_pcb (2024-06-08)

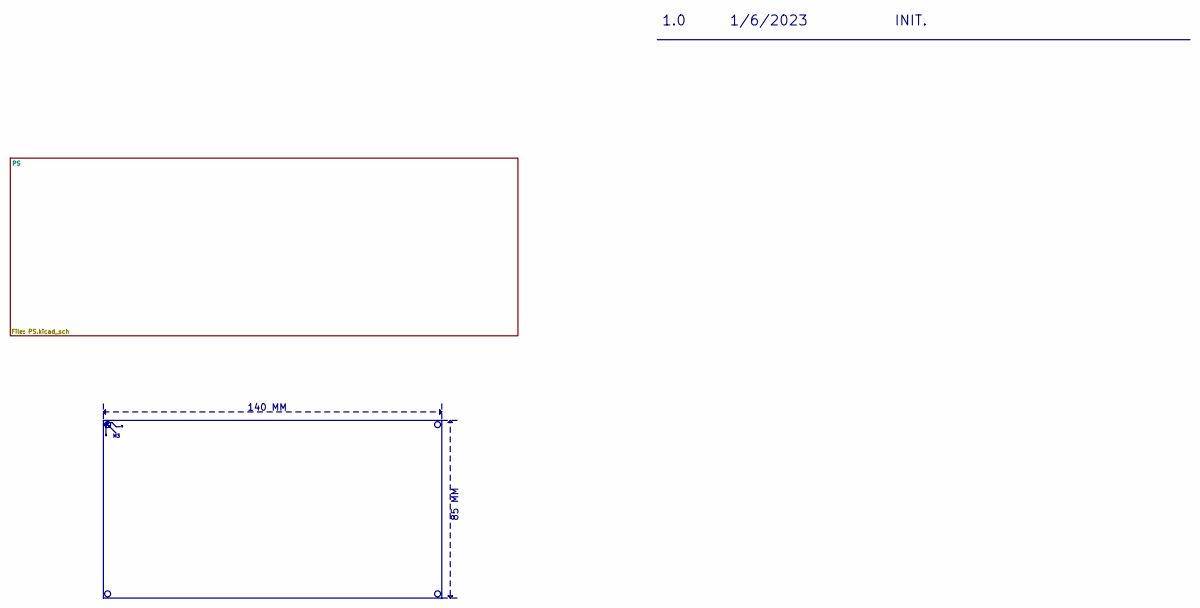
[picture p2: schematic ACDC120V24.kicad_sch]

Notes on the sheet:
85 MM
1/6/2023
140 MM
1.0
INIT.

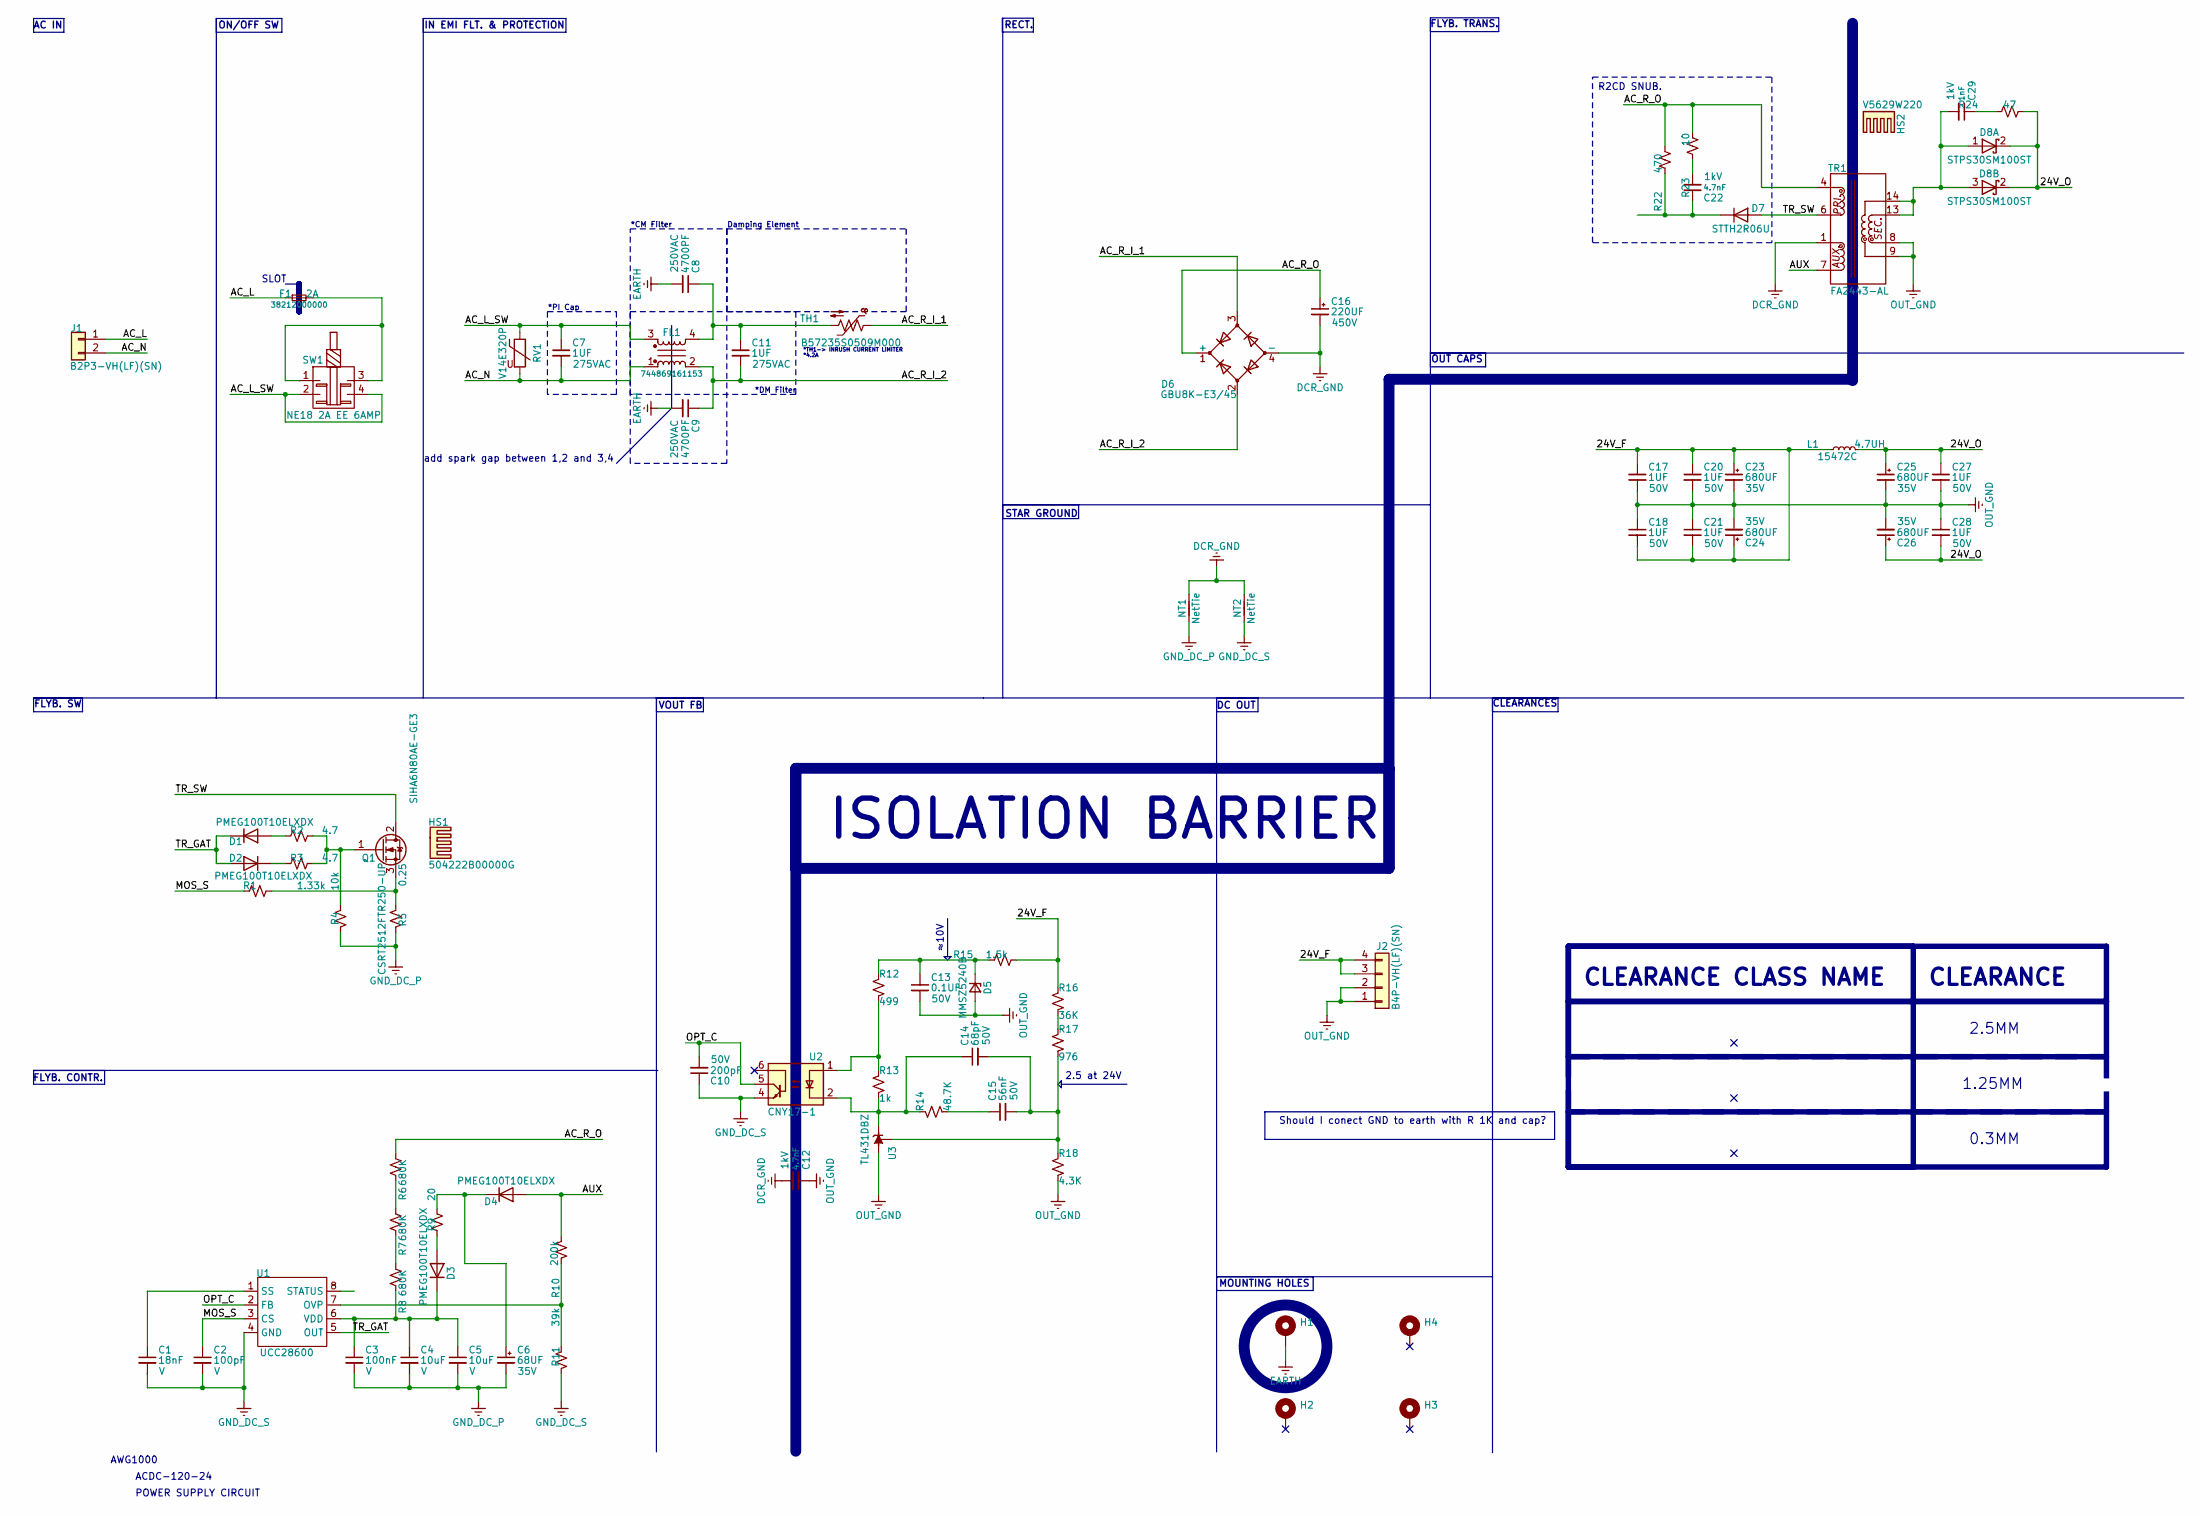
[picture p3: schematic PS.kicad_sch]

Parts:
C1: 18nF; C_0603_1608Metric; VOLTAGE V
C2: 100pF; C_0603_1608Metric; VOLTAGE V
C3: 100nF; C_0603_1608Metric; VOLTAGE V
C4, C5: 10uF; C_0603_1608Metric; VOLTAGE V
C6: 68UF; C_Radial_D6.3mm_H11.0mm_P2.50mm; VOLTAGE 35V
C7, C11: 1UF; 890324026027CS; VOLTAGE 275VAC
C8, C9: 4700PF; C_Disc_D10.5mm_W5.0mm_P5.00mm; VOLTAGE 250VAC
C10: 200pF; C_0603_1608Metric; VOLTAGE 50V
C12, C22: 4.7nF; C_Disc_D7.5mm_W5.0mm_P7.50mm; VOLTAGE 1kV
C13: 0.1UF; C_0603_1608Metric; VOLTAGE 50V
C14: 68pF; C_0603_1608Metric; VOLTAGE 50V
C15: 56nF; C_0603_1608Metric; VOLTAGE 50V
C16: 220UF; CP_Radial_D18.0mm_P7.50mm; VOLTAGE 450V
C17, C18, C20, C21, C27, C28: 1UF; C_0805_2012Metric_Pad1.18x1.45mm_HandSolder; VOLTAGE 50V
C23, C24, C25, C26: 680UF; EKZN630ELL681MK30S; VOLTAGE 35V
C29: 1nF; C_Disc_D7.5mm_W5.0mm_P7.50mm; VOLTAGE 1kV
D1, D2, D3, D4: PMEG100T10ELXDX; D_SOD-323
D5: MMSZ5240B; D_SOD-123F
D6: GBU8K-E3/45; Diode_Bridge_Vishay_GBU
D7: STTH2R06U; D_SMB
D8: STPS30SM100ST; TO-220-3_Vertical
F1: 38212000000; 38211000410; Current Rating 2A
FL1: 744869161153
H1, H2, H3, H4: MountingHole_Pad; MountingHole_3.2mm_M3_DIN965_Pad_TopBottom
HS1: 504222B00000G
HS2: V5629W220
J1: B2P3-VH(LF)(SN); JST_VH_B2P3-VH_1x02_P7.92mm_Vertical
J2: B4P-VH(LF)(SN); JST_VH_B4P-VH-B_1x04_P3.96mm_Vertical
L1: 4.7UH; 744750340047
NT1: NetTie; NetTie-2_SMD_Pad2.0mm
NT2: NetTie; NetTie-2_SMD_Pad0.5mm
Q1: SIHA6N80AE-GE3
R1: 1.33k; R_0603_1608Metric
R2, R3: 4.7; R_0603_1608Metric
R4: 10k; R_0603_1608Metric
R5: 0.25; R_2512_6332Metric_Pad1.40x3.35mm_HandSolder
R6, R7, R8: 680K; R_1206_3216Metric_Pad1.30x1.75mm_HandSolder
R9: 20; R_0603_1608Metric
R10: 200k; R_0603_1608Metric
R11: 39k; R_0603_1608Metric
R12: 499; R_0603_1608Metric
R13: 1k; R_0603_1608Metric
R14: 48.7K; R_0603_1608Metric
R15: 1.5k; R_0603_1608Metric
R16: 36K; R_0603_1608Metric
R17: 976; R_0603_1608Metric
R18: 4.3K; R_0603_1608Metric
R22: 470; R_Axial_DIN0516_L15.5mm_D5.0mm_P5.08mm_Vertical
R23: 10; R_Axial_DIN0516_L15.5mm_D5.0mm_P5.08mm_Vertical
R24: 47; R_Axial_DIN0516_L15.5mm_D5.0mm_P5.08mm_Vertical
RV1: V14E320P; RV_Disc_D16.5mm_W6.7mm_P7.5mm
SW1: NE18 2A EE 6AMP; NE1846EE
TH1: B57235S0509M000; RV_Disc_D9mm_W6.1mm_P5mm
TR1: FA2443-AL
U1: UCC28600; SOIC-8_3.9x4.9mm_P1.27mm
U2: CNY17-1; DIP-6_W7.62mm_LongPads
U3: TL431DBZ; SOT-23

Connections:
/PS/24V_F: C17.1, C18.2, C20.1, C21.2, C23.1, C24.1, J2.3, J2.4, L1.1, R15.2, R16.2
/PS/24V_O: C25.1, C26.1, C27.1, C28.2, D8.2 (K), L1.2, R24.2
/PS/AC_L: F1.1, J1.1
/PS/AC_L_SW: C7.1, FL1.3, RV1.1, SW1.2, SW1.4
/PS/AC_N: C7.2, FL1.1, J1.2, RV1.2
/PS/AC_R_I_1: D6.3, TH1.1
/PS/AC_R_I_2: C9.1, C11.2, D6.2, FL1.2
/PS/AC_R_O: C16.1, D6.1 (+), R6.2, R22.2, R23.2, TR1.4
/PS/AUX: D4.2 (A), R10.2, TR1.7
/PS/MOS_S: C2.1, R1.2, U1.3 (CS)
/PS/OPT_C: C10.2, U1.2 (FB), U2.5
/PS/TR_GAT: D1.1 (K), D2.2 (A), U1.5 (OUT)
/PS/TR_SW: D7.2 (A), Q1.2 (D), TR1.6
DCR_GND: C12.2, C16.2, D6.4 (-), NT1.2, NT2.2, TR1.1
EARTH: C8.2, C9.2, H1.1
GND_DC_P: C3.2, C4.2, C5.2, C6.2, NT1.1, R4.2, R5.2
GND_DC_S: C1.2, C2.2, C10.1, NT2.1, R11.2, U1.4 (GND), U2.4
unnamed: C8.1, C11.1, FL1.4, TH1.2
unnamed: C15.1, R14.1
unnamed: C22.2, R23.1
unnamed: C29.1, R24.1
unnamed: D1.2 (A), R2.2
unnamed: D2.1 (K), R3.2
unnamed: D3.2 (A), R9.2
unnamed: C3.1, C4.1, C5.1, D3.1 (K), R8.1, U1.6 (VDD)
unnamed: C6.1, D4.1 (K), R9.1
unnamed: C13.1, D5.1 (K), R12.2, R15.1
unnamed: C22.1, D7.1 (K), R22.1
unnamed: C29.2, D8.1 (A), D8.3 (K), TR1.13, TR1.14
unnamed: F1.2, SW1.1, SW1.3
unnamed: Q1.1 (G), R2.1, R3.1, R4.1
unnamed: Q1.3 (S), R1.1, R5.1
unnamed: R6.1, R7.2
unnamed: R7.1, R8.2
unnamed: R12.1, R13.2, U2.1
unnamed: R16.1, R17.2
unnamed: R10.1, R11.1, U1.7 (OVP)
unnamed: C1.1, U1.1 (SS)
unnamed: C14.1, R13.1, R14.2, U2.2, U3.1 (K)
unnamed: C14.2, C15.2, R17.1, R18.2, U3.2 (REF)
OUT_GND: C12.1, C13.2, C17.2, C18.1, C20.2, C21.1, C23.2, C24.2, C25.2, C26.2, C27.2, C28.1, D5.2 (A), J2.1, J2.2, R18.1, TR1.8, TR1.9, U3.3 (A)

Notes on the sheet:
CLEARANCE CLASS NAME
MOUNTING HOLES
2.5MM
OUT CAPS
RECT.
VOUT FB
POWER SUPPLY CIRCUIT
IN EMI FLT. & PROTECTION
AC IN
1.25MM
CLEARANCE
2.5 at 24V
*PI Cap
Damping Element
add spark gap between 1,2 and 3,4
FLYB. CONTR.
*4.2A
CLEARANCES
≈10V
AWG1000
*CM Filter
Should I conect GND to earth with R 1K and cap?
FLYB. TRANS.
ACDC-120-24
*DM Filter
*TH1-> INRUSH CURRENT LIMITER
DC OUT
STAR GROUND
ON/OFF SW
ISOLATION BARRIER
0.3MM
FLYB. SW
SLOT
R2CD SNUB.

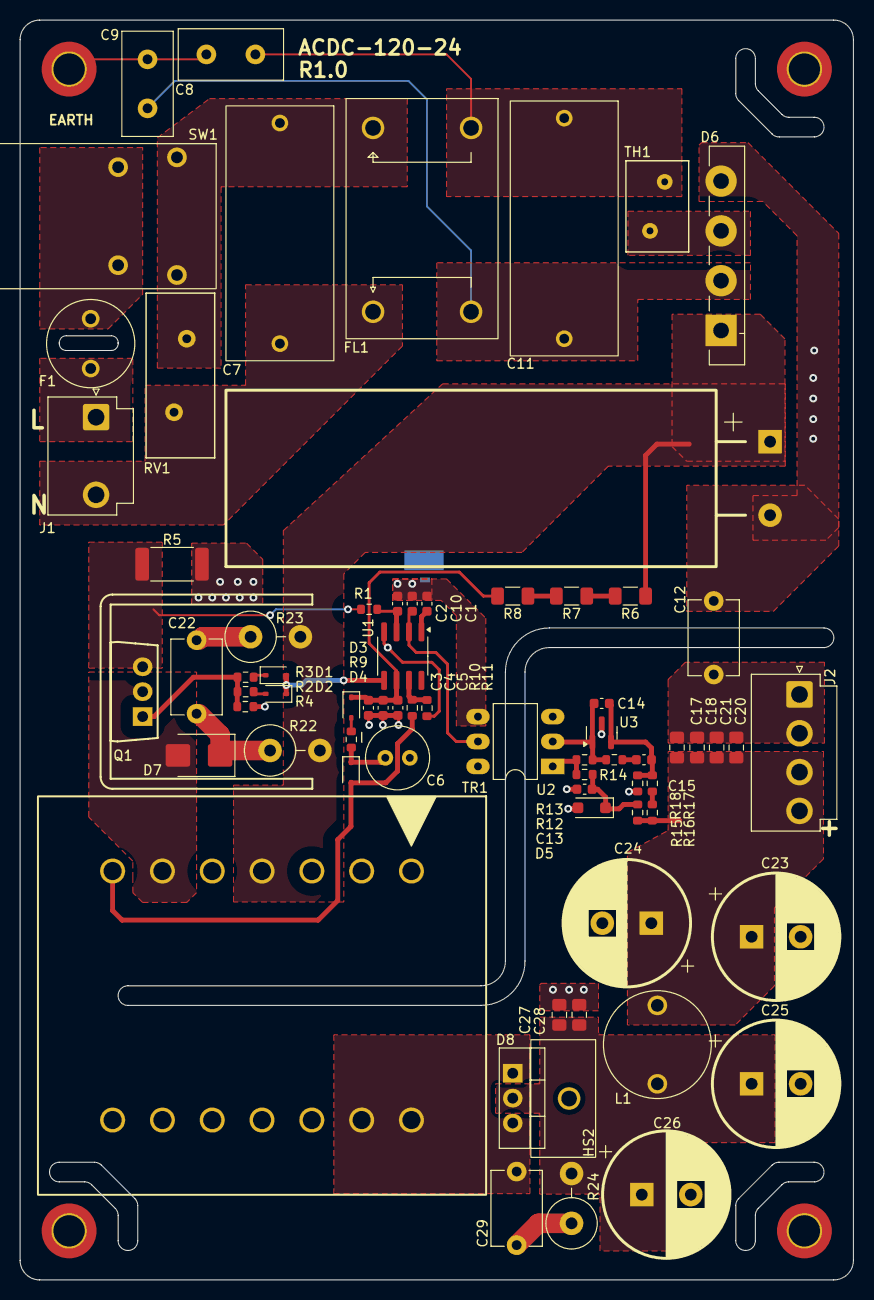
[picture p4: board ACDC120V24.kicad_pcb from above]

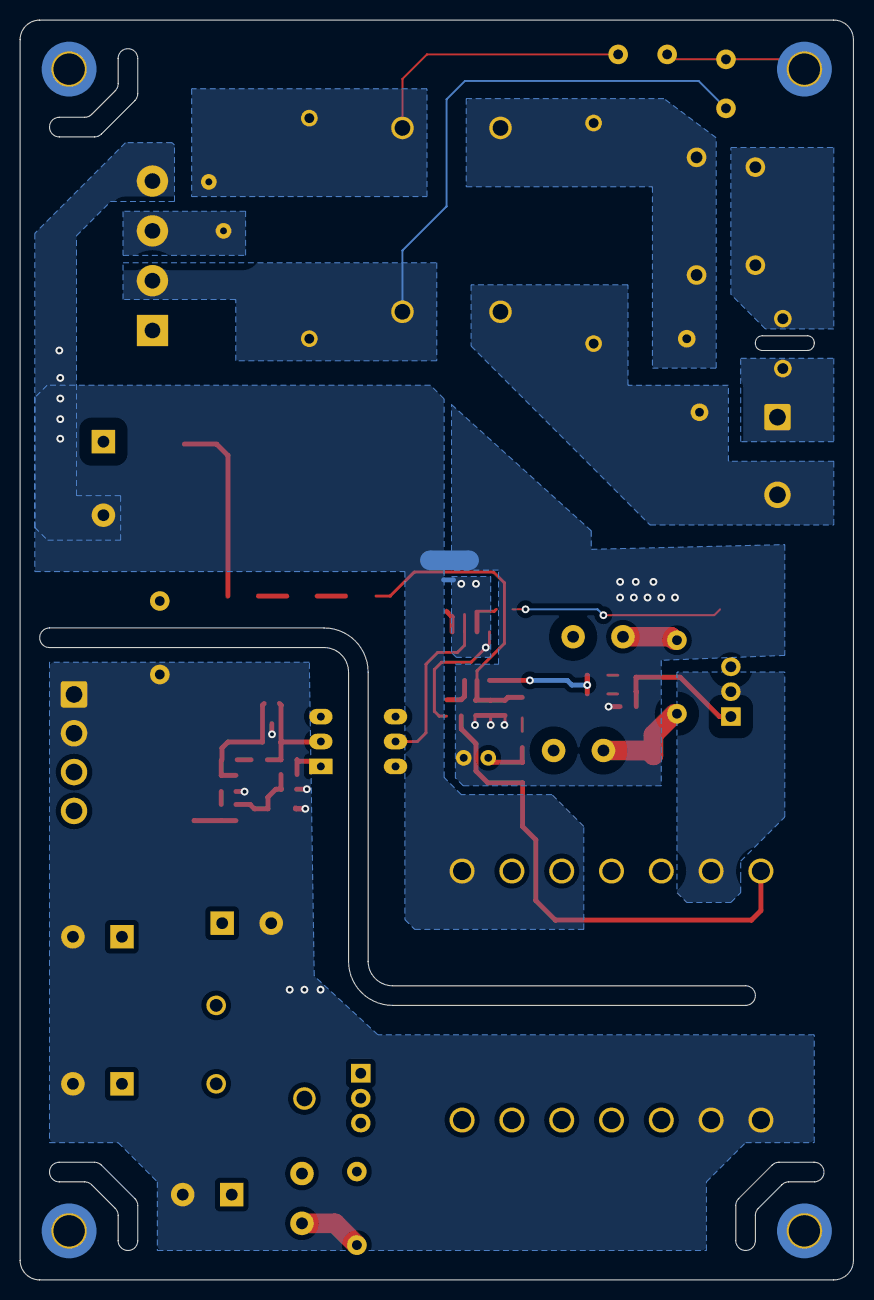
[picture p5: board ACDC120V24.kicad_pcb from below]

Board: 2 copper layers, 85.0 x 128.5 mm, 77 parts (3 on the bottom side), 41 nets.
