Anastien/ACDC120V24/(commit log)

2023-09-03 *Adding Feedback Circuit Simulation.
    [PS.kicad_sch]
2023-09-13 FOLDER STRUCTURE UPDATE.
    [ACDC150V24.kicad_pcb, ACDC150V24.kicad_sch, ACDC_120_24.iges, ACDC_60_24.dxf, Copy of slvc104j.xls, PS.kicad_sch, WBBOMDesignUCC28600DR.csv, bom.csv]
2023-11-21 Adding To-Do.txt , First initial working Design.
    [ACDC150V24-B_Cu.gbr, ACDC150V24-B_Mask.gbr, ACDC150V24-B_Paste.gbr, ACDC150V24-B_SilkS.gbr, ACDC150V24-Edge_Cuts.gbr, ACDC150V24-F_Cu.gbr, ACDC150V24-F_Mask.gbr, ACDC150V24-F_Paste.gbr]
2023-12-09 Regular Update.
    [ACDC150V24.kicad_sch, PS.kicad_sch]
2024-02-17 Changing Mosfet.
    [ACDC150V24.kicad_pcb, ACDC150V24.kicad_sch, PS.kicad_sch]
2024-05-20 Update from 150W to 120W.
    [ACDC120V24.kicad_pcb, ACDC120V24.kicad_sch, ACDC150V24.kicad_pcb, ACDC150V24.kicad_sch, ACDC_120_24.iges, ACDC_60_24.dxf, PS.kicad_sch]
